lizhelun123-beep/Zynq-7020_pynq_ray_game/build/reports/camera_model_reanalysis/sampling_paths.tsv

lane | polarity | corner | data_transition | delay_type | path_count | worst_slack_ns
0 | p | Fast | rise | max | 4 | 0.036
0 | p | Fast | rise | min | 4 | 0.279
0 | p | Fast | fall | max | 4 | 0.036
0 | p | Fast | fall | min | 4 | 0.279
0 | p | Slow | rise | max | 4 | 1.016
0 | p | Slow | rise | min | 4 | -0.844
0 | p | Slow | fall | max | 4 | 1.016
0 | p | Slow | fall | min | 4 | -0.844
0 | n | Fast | rise | max | 4 | 0.034
0 | n | Fast | rise | min | 4 | 0.281
0 | n | Fast | fall | max | 4 | 0.034
0 | n | Fast | fall | min | 4 | 0.281
0 | n | Slow | rise | max | 4 | 1.014
0 | n | Slow | rise | min | 4 | -0.842
0 | n | Slow | fall | max | 4 | 1.014
0 | n | Slow | fall | min | 4 | -0.842
1 | p | Fast | rise | max | 4 | 0.023
1 | p | Fast | rise | min | 4 | 0.292
1 | p | Fast | fall | max | 4 | 0.023
1 | p | Fast | fall | min | 4 | 0.292
1 | p | Slow | rise | max | 4 | 1.002
1 | p | Slow | rise | min | 4 | -0.830
1 | p | Slow | fall | max | 4 | 1.002
1 | p | Slow | fall | min | 4 | -0.830
1 | n | Fast | rise | max | 4 | 0.021
1 | n | Fast | rise | min | 4 | 0.294
1 | n | Fast | fall | max | 4 | 0.021
1 | n | Fast | fall | min | 4 | 0.294
1 | n | Slow | rise | max | 4 | 1.000
1 | n | Slow | rise | min | 4 | -0.828
1 | n | Slow | fall | max | 4 | 1.000
1 | n | Slow | fall | min | 4 | -0.828
