lizhelun123-beep/Zynq-7020_pynq_ray_game/build/reports/camera_model_reanalysis/sampling_summary.tsv

metric | value
sampling_setup_ns | 0.021
sampling_hold_ns | -0.844
covered_queries | 32
fixed_IDELAY_and_locations | UNCHANGED
timing_status | FAIL
