lizhelun123-beep/Zynq-7020_pynq_ray_game/build/reports/final_camera_build/reports/timing_gate.tsv

delay_type | worst_slack_ns
max | 0.021
min | -0.844
