lizhelun123-beep/Zynq-7020_pynq_ray_game/build/reports/camera_model_reanalysis/inputs/pl2_reports/timing_gate.tsv

delay_type | worst_slack_ns
max | 0.303
min | -1.111
