lizhelun123-beep/Zynq-7020_pynq_ray_game/data/reference/screen_02.png

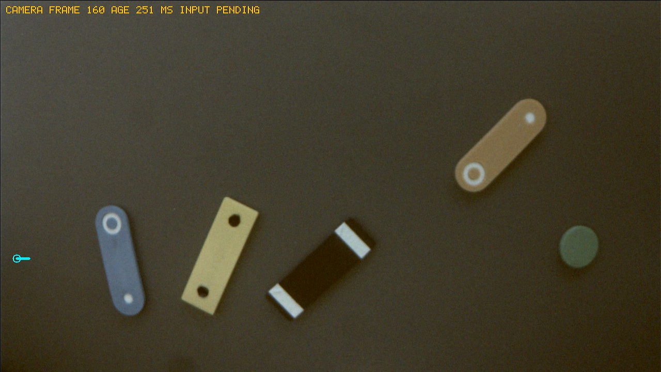
data/reference/screen_02.png
