lizhelun123-beep/Zynq-7020_pynq_ray_game/data/test_data/index.tsv

sample_id | upload_order | file | original_file | source_path | bytes | sha256 | width | height | image_mode | data_role | expected_types | observed_types | requested_placement | observed_placement | placement_review | label_basis | geometry_annotation | filename_time_semantics | reference_relationship | sensor_raw_status
43 | 1 | raw/01.png | Screenshot 2026-11-02 19-59-07.png | C:/Users/11967/Videos/Screenshot 2026-11-02 19-59-07.png | 1270483 | 2f3a45b0bfd4c9fe3474bf07124e5293e8f3855c91941d0a6402e2babf1b7486 | 1280 | 720 | RGB | ALGORITHM_TEST_INPUT | MIRROR | MIRROR | 只有Mirror，水平摆放，位于画面中部。 | 黄色主体及两端黑点，长轴近水平，单物块完整入镜。 | VISUAL_IDENTITY_AND_LAYOUT_REVIEWED | USER_REQUEST_AND_MANUAL_IMAGE_REVIEW_BEFORE_C_REPLAY | PENDING_INDEPENDENT_CENTER_AXIS_BOUNDARY_LABELS | FILENAME_ONLY_NOT_VERIFIED_EXPOSURE_TIME | NO_SYNCHRONIZED_OR_SAME_FRAME_BINDING | PNG_UPLOAD_NOT_SENSOR_RAW10
44 | 2 | raw/02.png | Screenshot 2026-11-02 19-59-19.png | C:/Users/11967/Videos/Screenshot 2026-11-02 19-59-19.png | 1301689 | 123bdf364a8dd263ad06cc3c40afd0b89b04add67df74252bbe95b522e2a0216 | 1280 | 720 | RGB | ALGORITHM_TEST_INPUT | MIRROR | MIRROR | Mirror中心基本不变，旋转为竖直。 | 黄色主体及两端黑点，长轴近竖直，单物块完整入镜。 | VISUAL_IDENTITY_AND_LAYOUT_REVIEWED | USER_REQUEST_AND_MANUAL_IMAGE_REVIEW_BEFORE_C_REPLAY | PENDING_INDEPENDENT_CENTER_AXIS_BOUNDARY_LABELS | FILENAME_ONLY_NOT_VERIFIED_EXPOSURE_TIME | NO_SYNCHRONIZED_OR_SAME_FRAME_BINDING | PNG_UPLOAD_NOT_SENSOR_RAW10
45 | 3 | raw/03.png | Screenshot 2026-11-02 19-59-26.png | C:/Users/11967/Videos/Screenshot 2026-11-02 19-59-26.png | 1323438 | 65e117a853ddf29dfbc0390baccc5861907d2da0ac96ad632eacbb465f8e55ef | 1280 | 720 | RGB | ALGORITHM_TEST_INPUT | MIRROR | MIRROR | Mirror中心基本不变，旋转为约45°。 | 黄色主体及两端黑点，长轴从左下至右上，约45°。 | VISUAL_IDENTITY_AND_LAYOUT_REVIEWED | USER_REQUEST_AND_MANUAL_IMAGE_REVIEW_BEFORE_C_REPLAY | PENDING_INDEPENDENT_CENTER_AXIS_BOUNDARY_LABELS | FILENAME_ONLY_NOT_VERIFIED_EXPOSURE_TIME | NO_SYNCHRONIZED_OR_SAME_FRAME_BINDING | PNG_UPLOAD_NOT_SENSOR_RAW10
46 | 4 | raw/07.png | Screenshot 2026-11-02 20-00-09.png | C:/Users/11967/Videos/Screenshot 2026-11-02 20-00-09.png | 1350614 | 4c739790013804a8c909c1af2ee445849e6cff5d7746e8f3e66c023ad1a7e6b9 | 1280 | 720 | RGB | ALGORITHM_TEST_INPUT | PORTAL_A | PORTAL_A | 只有Portal A，水平摆放，实心点在左、圆环在右。 | 蓝色主体，白色实心点在左、圆环在右，长轴近水平。 | VISUAL_IDENTITY_AND_LAYOUT_REVIEWED | USER_REQUEST_AND_MANUAL_IMAGE_REVIEW_BEFORE_C_REPLAY | PENDING_INDEPENDENT_CENTER_AXIS_BOUNDARY_LABELS | FILENAME_ONLY_NOT_VERIFIED_EXPOSURE_TIME | NO_SYNCHRONIZED_OR_SAME_FRAME_BINDING | PNG_UPLOAD_NOT_SENSOR_RAW10
47 | 5 | raw/05.png | Screenshot 2026-11-02 19-59-50.png | C:/Users/11967/Videos/Screenshot 2026-11-02 19-59-50.png | 1344861 | 70a1481f10ec8632ddb638e63eaa113ec23644ea6bdb5571796d05816061ed20 | 1280 | 720 | RGB | ALGORITHM_TEST_INPUT | PORTAL_A | PORTAL_A | Portal A竖直摆放，实心点在下、圆环在上。 | 蓝色主体，白色实心点在下、圆环在上，长轴近竖直。 | VISUAL_IDENTITY_AND_LAYOUT_REVIEWED | USER_REQUEST_AND_MANUAL_IMAGE_REVIEW_BEFORE_C_REPLAY | PENDING_INDEPENDENT_CENTER_AXIS_BOUNDARY_LABELS | FILENAME_ONLY_NOT_VERIFIED_EXPOSURE_TIME | NO_SYNCHRONIZED_OR_SAME_FRAME_BINDING | PNG_UPLOAD_NOT_SENSOR_RAW10
48 | 6 | raw/06.png | Screenshot 2026-11-02 20-00-00.png | C:/Users/11967/Videos/Screenshot 2026-11-02 20-00-00.png | 1345926 | 95be681b8a0554215d866c6fdedefc4556b70f96fe7e083aceb2ffe74dc683e9 | 1280 | 720 | RGB | ALGORITHM_TEST_INPUT | PORTAL_A | PORTAL_A | Portal A约45°摆放，实心点在左下、圆环在右上。 | 蓝色主体，白色实心点在左下、圆环在右上，长轴约45°。 | VISUAL_IDENTITY_AND_LAYOUT_REVIEWED | USER_REQUEST_AND_MANUAL_IMAGE_REVIEW_BEFORE_C_REPLAY | PENDING_INDEPENDENT_CENTER_AXIS_BOUNDARY_LABELS | FILENAME_ONLY_NOT_VERIFIED_EXPOSURE_TIME | NO_SYNCHRONIZED_OR_SAME_FRAME_BINDING | PNG_UPLOAD_NOT_SENSOR_RAW10
49 | 7 | raw/04.png | Screenshot 2026-11-02 19-59-38.png | C:/Users/11967/Videos/Screenshot 2026-11-02 19-59-38.png | 1313438 | ba6139d1a51e422aa84b228ab6b405609d179cca18bbc5f0a7e528cc7624eb6c | 1280 | 720 | RGB | ALGORITHM_TEST_INPUT | PORTAL_A | PORTAL_A | Portal A水平反向摆放，实心点在右、圆环在左。 | 蓝色主体，白色实心点在右、圆环在左，长轴近水平。 | VISUAL_IDENTITY_AND_LAYOUT_REVIEWED | USER_REQUEST_AND_MANUAL_IMAGE_REVIEW_BEFORE_C_REPLAY | PENDING_INDEPENDENT_CENTER_AXIS_BOUNDARY_LABELS | FILENAME_ONLY_NOT_VERIFIED_EXPOSURE_TIME | NO_SYNCHRONIZED_OR_SAME_FRAME_BINDING | PNG_UPLOAD_NOT_SENSOR_RAW10
50 | 8 | raw/08.png | Screenshot 2026-11-02 20-00-39.png | C:/Users/11967/Videos/Screenshot 2026-11-02 20-00-39.png | 1370984 | 831b0ded6e29ecee51226f95462f2510518f40d29e7abd3ff05f95d32c1e73b6 | 1280 | 720 | RGB | ALGORITHM_TEST_INPUT | PORTAL_B | PORTAL_B | 只有Portal B，水平摆放，实心点在左、圆环在右。 | 橙色主体，白色实心点在左、圆环在右，长轴近水平。 | VISUAL_IDENTITY_AND_LAYOUT_REVIEWED | USER_REQUEST_AND_MANUAL_IMAGE_REVIEW_BEFORE_C_REPLAY | PENDING_INDEPENDENT_CENTER_AXIS_BOUNDARY_LABELS | FILENAME_ONLY_NOT_VERIFIED_EXPOSURE_TIME | NO_SYNCHRONIZED_OR_SAME_FRAME_BINDING | PNG_UPLOAD_NOT_SENSOR_RAW10
51 | 9 | raw/09.png | Screenshot 2026-11-02 20-00-53.png | C:/Users/11967/Videos/Screenshot 2026-11-02 20-00-53.png | 1376443 | 513a161e1db5ed2d8f65e204740cf6f02557e9e55281cee433263ee47509b2ad | 1280 | 720 | RGB | ALGORITHM_TEST_INPUT | PORTAL_B | PORTAL_B | Portal B竖直摆放，实心点在下、圆环在上。 | 橙色主体，白色实心点在下、圆环在上，长轴近竖直。 | VISUAL_IDENTITY_AND_LAYOUT_REVIEWED | USER_REQUEST_AND_MANUAL_IMAGE_REVIEW_BEFORE_C_REPLAY | PENDING_INDEPENDENT_CENTER_AXIS_BOUNDARY_LABELS | FILENAME_ONLY_NOT_VERIFIED_EXPOSURE_TIME | NO_SYNCHRONIZED_OR_SAME_FRAME_BINDING | PNG_UPLOAD_NOT_SENSOR_RAW10
52 | 10 | raw/10.png | Screenshot 2026-11-02 20-00-59.png | C:/Users/11967/Videos/Screenshot 2026-11-02 20-00-59.png | 1377696 | 8d167ce49a91a2117f9b7bee8b43513886d5db915b36d2b0f6699d26568319ce | 1280 | 720 | RGB | ALGORITHM_TEST_INPUT | PORTAL_B | PORTAL_B | Portal B约45°摆放，实心点在左下、圆环在右上。 | 橙色主体，白色实心点在左下、圆环在右上，长轴约45°。 | VISUAL_IDENTITY_AND_LAYOUT_REVIEWED | USER_REQUEST_AND_MANUAL_IMAGE_REVIEW_BEFORE_C_REPLAY | PENDING_INDEPENDENT_CENTER_AXIS_BOUNDARY_LABELS | FILENAME_ONLY_NOT_VERIFIED_EXPOSURE_TIME | NO_SYNCHRONIZED_OR_SAME_FRAME_BINDING | PNG_UPLOAD_NOT_SENSOR_RAW10
53 | 11 | raw/11.png | Screenshot 2026-11-02 20-02-07.png | C:/Users/11967/Videos/Screenshot 2026-11-02 20-02-07.png | 1395611 | 94b515042fd1ad5d4e42d4cc2a1c4e7682ccf41fbc4f03802dda197e801b23cd | 1280 | 720 | RGB | ALGORITHM_TEST_INPUT | PORTAL_B | PORTAL_B | Portal B水平反向摆放，实心点在右、圆环在左。 | 橙色主体，白色实心点在右、圆环在左，长轴近水平。 | VISUAL_IDENTITY_AND_LAYOUT_REVIEWED | USER_REQUEST_AND_MANUAL_IMAGE_REVIEW_BEFORE_C_REPLAY | PENDING_INDEPENDENT_CENTER_AXIS_BOUNDARY_LABELS | FILENAME_ONLY_NOT_VERIFIED_EXPOSURE_TIME | NO_SYNCHRONIZED_OR_SAME_FRAME_BINDING | PNG_UPLOAD_NOT_SENSOR_RAW10
54 | 12 | raw/12.png | Screenshot 2026-11-02 20-02-17.png | C:/Users/11967/Videos/Screenshot 2026-11-02 20-02-17.png | 1393155 | 370e5a95cc30109d4b3005c137089873bfe207f99f4f6320b11b1553fa2c3e4e | 1280 | 720 | RGB | ALGORITHM_TEST_INPUT | WALL | WALL | 只有WALL，水平摆放，两端白色标记完整可见。 | 黑色条状主体，左右两端白条完整，长轴近水平。 | VISUAL_IDENTITY_AND_LAYOUT_REVIEWED | USER_REQUEST_AND_MANUAL_IMAGE_REVIEW_BEFORE_C_REPLAY | PENDING_INDEPENDENT_CENTER_AXIS_BOUNDARY_LABELS | FILENAME_ONLY_NOT_VERIFIED_EXPOSURE_TIME | NO_SYNCHRONIZED_OR_SAME_FRAME_BINDING | PNG_UPLOAD_NOT_SENSOR_RAW10
55 | 13 | raw/13.png | Screenshot 2026-11-02 20-02-27.png | C:/Users/11967/Videos/Screenshot 2026-11-02 20-02-27.png | 1397522 | 25cd7a6c5181fd2b277d5bf987df8fd6235429834e63f8f7e1e0a70fc6c1058d | 1280 | 720 | RGB | ALGORITHM_TEST_INPUT | WALL | WALL | WALL中心基本不变，旋转为竖直。 | 黑色条状主体，上下两端白条完整，长轴近竖直。 | VISUAL_IDENTITY_AND_LAYOUT_REVIEWED | USER_REQUEST_AND_MANUAL_IMAGE_REVIEW_BEFORE_C_REPLAY | PENDING_INDEPENDENT_CENTER_AXIS_BOUNDARY_LABELS | FILENAME_ONLY_NOT_VERIFIED_EXPOSURE_TIME | NO_SYNCHRONIZED_OR_SAME_FRAME_BINDING | PNG_UPLOAD_NOT_SENSOR_RAW10
56 | 14 | raw/14.png | Screenshot 2026-11-02 20-02-32.png | C:/Users/11967/Videos/Screenshot 2026-11-02 20-02-32.png | 1399271 | 9eee3dae4d5c119a5525255c1d3c501641b919a8e30fe9e2309180a5eaee42ba | 1280 | 720 | RGB | ALGORITHM_TEST_INPUT | WALL | WALL | WALL中心基本不变，旋转为约45°。 | 黑色条状主体，左下及右上两端白条完整，长轴约45°。 | VISUAL_IDENTITY_AND_LAYOUT_REVIEWED | USER_REQUEST_AND_MANUAL_IMAGE_REVIEW_BEFORE_C_REPLAY | PENDING_INDEPENDENT_CENTER_AXIS_BOUNDARY_LABELS | FILENAME_ONLY_NOT_VERIFIED_EXPOSURE_TIME | NO_SYNCHRONIZED_OR_SAME_FRAME_BINDING | PNG_UPLOAD_NOT_SENSOR_RAW10
57 | 15 | raw/15.png | Screenshot 2026-11-02 20-02-41.png | C:/Users/11967/Videos/Screenshot 2026-11-02 20-02-41.png | 1400688 | 037862dcbe06970b7ca0626e99148379db882f337940cf209bc1e69d8fe13807 | 1280 | 720 | RGB | ALGORITHM_TEST_INPUT | TARGET | TARGET | 只有Target，放在画面中央。 | 绿色圆形Target，位于画面中央附近，完整入镜。 | VISUAL_IDENTITY_AND_LAYOUT_REVIEWED | USER_REQUEST_AND_MANUAL_IMAGE_REVIEW_BEFORE_C_REPLAY | PENDING_INDEPENDENT_CENTER_AXIS_BOUNDARY_LABELS | FILENAME_ONLY_NOT_VERIFIED_EXPOSURE_TIME | NO_SYNCHRONIZED_OR_SAME_FRAME_BINDING | PNG_UPLOAD_NOT_SENSOR_RAW10
58 | 16 | raw/16.png | Screenshot 2026-11-02 20-02-48.png | C:/Users/11967/Videos/Screenshot 2026-11-02 20-02-48.png | 1397362 | 28fc8bf925732552c63430503873e98fc251a9554b210427d61accdb66e75b4c | 1280 | 720 | RGB | ALGORITHM_TEST_INPUT | TARGET | TARGET | Target放在左上区域，完整入镜并留边。 | 绿色圆形Target，位于左上区域，完整入镜并留边。 | VISUAL_IDENTITY_AND_LAYOUT_REVIEWED | USER_REQUEST_AND_MANUAL_IMAGE_REVIEW_BEFORE_C_REPLAY | PENDING_INDEPENDENT_CENTER_AXIS_BOUNDARY_LABELS | FILENAME_ONLY_NOT_VERIFIED_EXPOSURE_TIME | NO_SYNCHRONIZED_OR_SAME_FRAME_BINDING | PNG_UPLOAD_NOT_SENSOR_RAW10
59 | 17 | raw/17.png | Screenshot 2026-11-02 20-02-54.png | C:/Users/11967/Videos/Screenshot 2026-11-02 20-02-54.png | 1398810 | 47368bc88837ad782b83bc1ae56c29bf392019dc20263651b3bedce66dbb8a83 | 1280 | 720 | RGB | ALGORITHM_TEST_INPUT | TARGET | TARGET | Target放在右上区域，完整入镜并留边。 | 绿色圆形Target，位于右上区域，完整入镜并留边。 | VISUAL_IDENTITY_AND_LAYOUT_REVIEWED | USER_REQUEST_AND_MANUAL_IMAGE_REVIEW_BEFORE_C_REPLAY | PENDING_INDEPENDENT_CENTER_AXIS_BOUNDARY_LABELS | FILENAME_ONLY_NOT_VERIFIED_EXPOSURE_TIME | NO_SYNCHRONIZED_OR_SAME_FRAME_BINDING | PNG_UPLOAD_NOT_SENSOR_RAW10
60 | 18 | raw/18.png | Screenshot 2026-11-02 20-03-00.png | C:/Users/11967/Videos/Screenshot 2026-11-02 20-03-00.png | 1403587 | 4af9ef71a9bdafd9e7ac925378949e2a0de953861b67ed7c9b332c7a7f2a1dd5 | 1280 | 720 | RGB | ALGORITHM_TEST_INPUT | TARGET | TARGET | Target放在左下区域，完整入镜并留边。 | 绿色圆形Target，位于左下区域，完整入镜并留边。 | VISUAL_IDENTITY_AND_LAYOUT_REVIEWED | USER_REQUEST_AND_MANUAL_IMAGE_REVIEW_BEFORE_C_REPLAY | PENDING_INDEPENDENT_CENTER_AXIS_BOUNDARY_LABELS | FILENAME_ONLY_NOT_VERIFIED_EXPOSURE_TIME | NO_SYNCHRONIZED_OR_SAME_FRAME_BINDING | PNG_UPLOAD_NOT_SENSOR_RAW10
61 | 19 | raw/19.png | Screenshot 2026-11-02 20-03-06.png | C:/Users/11967/Videos/Screenshot 2026-11-02 20-03-06.png | 1391458 | 49904cf789f9c1cfd9a5990e7b267402fb1ea0ca718a77e8af1104f6284bb609 | 1280 | 720 | RGB | ALGORITHM_TEST_INPUT | TARGET | TARGET | Target放在右下区域，完整入镜并留边。 | 绿色圆形Target，位于右下区域，完整入镜并留边。 | VISUAL_IDENTITY_AND_LAYOUT_REVIEWED | USER_REQUEST_AND_MANUAL_IMAGE_REVIEW_BEFORE_C_REPLAY | PENDING_INDEPENDENT_CENTER_AXIS_BOUNDARY_LABELS | FILENAME_ONLY_NOT_VERIFIED_EXPOSURE_TIME | NO_SYNCHRONIZED_OR_SAME_FRAME_BINDING | PNG_UPLOAD_NOT_SENSOR_RAW10
62 | 20 | raw/20.png | Screenshot 2026-11-02 20-03-21.png | C:/Users/11967/Videos/Screenshot 2026-11-02 20-03-21.png | 1390234 | 16fa88c05733cfe5efb2e3e4152d6e2c81df6977cd7546abd3ade172dc347ccd | 1280 | 720 | RGB | ALGORITHM_TEST_INPUT | MIRROR;PORTAL_A;PORTAL_B;WALL;TARGET | MIRROR;PORTAL_A;PORTAL_B;WALL;TARGET | 五个正式物块全部放入，采用另一套位置和方向。 | 五物块均完整可见、无明显重叠；保留此图的摆放信息，不再与已排除图片比较。 | VISUAL_IDENTITY_AND_LAYOUT_REVIEWED | USER_REQUEST_AND_MANUAL_IMAGE_REVIEW_BEFORE_C_REPLAY | PENDING_INDEPENDENT_CENTER_AXIS_BOUNDARY_LABELS | FILENAME_ONLY_NOT_VERIFIED_EXPOSURE_TIME | NO_SYNCHRONIZED_OR_SAME_FRAME_BINDING | PNG_UPLOAD_NOT_SENSOR_RAW10
42 | 22 | raw/42.png | Screenshot 2026-11-02 19-58-47.png | C:/Users/11967/Videos/Screenshot 2026-11-02 19-58-47.png | 1256457 | b9178000612b9bf7059e6fe340c3945c5a4c7cea89f5b0608f5020081a241d51 | 1280 | 720 | RGB | ALGORITHM_TEST_INPUT |  |  | 移走全部物块和手，拍空场。 | 空场，画面内未见五类正式物块或手。 | VISUAL_IDENTITY_AND_LAYOUT_REVIEWED | USER_CONFIRMED_SAMPLE_ID_AND_MANUAL_IMAGE_REVIEW_BEFORE_C_REPLAY | NOT_APPLICABLE_EMPTY_SCENE | FILENAME_ONLY_NOT_VERIFIED_EXPOSURE_TIME | NO_SYNCHRONIZED_OR_SAME_FRAME_BINDING | PNG_UPLOAD_NOT_SENSOR_RAW10
