lizhelun123-beep/Zynq-7020_pynq_ray_game/build/reports/sampling_window_build/sampling_analysis/declared_25_75_paths.tsv

lane | polarity | corner | data_transition | delay_type | path_count | worst_slack_ns
0 | p | Fast | rise | max | 4 | 0.150
0 | p | Fast | rise | min | 4 | 0.942
0 | p | Fast | fall | max | 4 | 0.150
0 | p | Fast | fall | min | 4 | 0.942
0 | p | Slow | rise | max | 4 | 0.711
0 | p | Slow | rise | min | 4 | 0.201
0 | p | Slow | fall | max | 4 | 0.711
0 | p | Slow | fall | min | 4 | 0.201
0 | n | Fast | rise | max | 4 | 0.148
0 | n | Fast | rise | min | 4 | 0.944
0 | n | Fast | fall | max | 4 | 0.148
0 | n | Fast | fall | min | 4 | 0.944
0 | n | Slow | rise | max | 4 | 0.709
0 | n | Slow | rise | min | 4 | 0.203
0 | n | Slow | fall | max | 4 | 0.709
0 | n | Slow | fall | min | 4 | 0.203
1 | p | Fast | rise | max | 4 | 0.137
1 | p | Fast | rise | min | 4 | 0.955
1 | p | Fast | fall | max | 4 | 0.137
1 | p | Fast | fall | min | 4 | 0.955
1 | p | Slow | rise | max | 4 | 0.697
1 | p | Slow | rise | min | 4 | 0.215
1 | p | Slow | fall | max | 4 | 0.697
1 | p | Slow | fall | min | 4 | 0.215
1 | n | Fast | rise | max | 4 | 0.135
1 | n | Fast | rise | min | 4 | 0.957
1 | n | Fast | fall | max | 4 | 0.135
1 | n | Fast | fall | min | 4 | 0.957
1 | n | Slow | rise | max | 4 | 0.695
1 | n | Slow | rise | min | 4 | 0.217
1 | n | Slow | fall | max | 4 | 0.695
1 | n | Slow | fall | min | 4 | 0.217
