lizhelun123-beep/Zynq-7020_pynq_ray_game/build/reports/sampling_window_build/sampling_analysis/historical_15_85_paths.tsv

lane | polarity | corner | data_transition | delay_type | path_count | worst_slack_ns
0 | p | Fast | rise | max | 4 | -0.207
0 | p | Fast | rise | min | 4 | 0.585
0 | p | Fast | fall | max | 4 | -0.207
0 | p | Fast | fall | min | 4 | 0.585
0 | p | Slow | rise | max | 4 | 0.354
0 | p | Slow | rise | min | 4 | -0.156
0 | p | Slow | fall | max | 4 | 0.354
0 | p | Slow | fall | min | 4 | -0.156
0 | n | Fast | rise | max | 4 | -0.209
0 | n | Fast | rise | min | 4 | 0.587
0 | n | Fast | fall | max | 4 | -0.209
0 | n | Fast | fall | min | 4 | 0.587
0 | n | Slow | rise | max | 4 | 0.352
0 | n | Slow | rise | min | 4 | -0.154
0 | n | Slow | fall | max | 4 | 0.352
0 | n | Slow | fall | min | 4 | -0.154
1 | p | Fast | rise | max | 4 | -0.220
1 | p | Fast | rise | min | 4 | 0.598
1 | p | Fast | fall | max | 4 | -0.220
1 | p | Fast | fall | min | 4 | 0.598
1 | p | Slow | rise | max | 4 | 0.340
1 | p | Slow | rise | min | 4 | -0.142
1 | p | Slow | fall | max | 4 | 0.340
1 | p | Slow | fall | min | 4 | -0.142
1 | n | Fast | rise | max | 4 | -0.222
1 | n | Fast | rise | min | 4 | 0.600
1 | n | Fast | fall | max | 4 | -0.222
1 | n | Fast | fall | min | 4 | 0.600
1 | n | Slow | rise | max | 4 | 0.338
1 | n | Slow | rise | min | 4 | -0.140
1 | n | Slow | fall | max | 4 | 0.338
1 | n | Slow | fall | min | 4 | -0.140
