lizhelun123-beep/Zynq-7020_pynq_ray_game/build/reports/sampling_window_build/sampling_analysis/sampling_summary.tsv

model | min_input_ns | max_input_ns | queries | paths | setup_ns | hold_ns | qualification
declared_25_75 | 0.892 | 2.679 | 32 | 128 | 0.135 | 0.201 | PASS_UNDER_DECLARED_MODEL
historical_15_85 | 0.535 | 3.036 | 32 | 128 | -0.222 | -0.156 | FAIL
