lizhelun123-beep/Zynq-7020_pynq_ray_game/build/reports/final_camera_build/reports/timing_result.tsv

status | detail
FAIL | min: slack=-0.844; Timing summary does not confirm all user timing constraints
