lizhelun123-beep/Zynq-7020_pynq_ray_game/build/reports/sampling_window_build/reports/timing_result.tsv

status | detail
PASS
