lizhelun123-beep/Zynq-7020_pynq_ray_game/data/reference_results/hdmi/index.tsv

sample_id | file | original_file | bytes | sha256 | width | height | displayed_frame | displayed_age_ms | display_mode | input_status | runtime_version | evidence_type | visual_note | data_role | algorithm_test_input | capture_relationship | reference_use
hdmi_001 | hdmi_001.png | Screenshot 2026-11-02 18-38-25.png | 1386012 | 5b880dfa2e9c79b9326dc334579db036ef34efebfa548cccd09f56058130bfe3 | 1280 | 720 | 363 | 280 | CAMERA | OK | UNBOUND | user-provided HDMI screenshot with existing overlay | orange portal, mirror, target; short ray ending near portal | REFERENCE_RESULT | NO | NOT_SYNCHRONOUS_USER_CONFIRMED | layout and visible output illustration only
hdmi_002 | hdmi_002.png | Screenshot 2026-11-02 18-38-32.png | 1386903 | 41984f7cbbfeb187953bff6a232b742a2f3f0f476d5afef540b29fd43196628e | 1280 | 720 | 381 | 278 | CAMERA | OK | UNBOUND | user-provided HDMI screenshot with existing overlay | same visible arrangement as preceding image | REFERENCE_RESULT | NO | NOT_SYNCHRONOUS_USER_CONFIRMED | layout and visible output illustration only
hdmi_003 | hdmi_003.png | Screenshot 2026-11-02 18-41-24.png | 1397052 | 61dcbca690ed41cd0d2fb9c48621f09bb4d43c69c23f4bf3ce61ceca53110c7c | 1280 | 720 | 820 | 2145 | STALE | PENDING | UNBOUND | user-provided HDMI screenshot with existing overlay | five visible object types; portal ray segments | REFERENCE_RESULT | NO | NOT_SYNCHRONOUS_USER_CONFIRMED | layout and visible output illustration only
hdmi_004 | hdmi_004.png | Screenshot 2026-11-02 18-43-38.png | 1405172 | 8f737a3609249bccfffefdca320d72791a3009df4faeda5166ec141c812314d7 | 1280 | 720 | 1134 | 2244 | STALE | PENDING | UNBOUND | user-provided HDMI screenshot with existing overlay | five visible object types; mirror reflection | REFERENCE_RESULT | NO | NOT_SYNCHRONOUS_USER_CONFIRMED | layout and visible output illustration only
hdmi_005 | hdmi_005.png | Screenshot 2026-11-02 18-45-14.png | 1409329 | 90884076a8d7a57e5248b9cb5659fa8e731771b9191c1392b8befafd5651dc40 | 1280 | 720 | 1380 | 617 | STALE | PENDING | UNBOUND | user-provided HDMI screenshot with existing overlay | mirror and target; reflection near mirror middle | REFERENCE_RESULT | NO | NOT_SYNCHRONOUS_USER_CONFIRMED | layout and visible output illustration only
hdmi_006 | hdmi_006.png | Screenshot 2026-11-02 18-45-53.png | 1409463 | ab71a9766c86aa8c9683ecaf4aac73207e2e699038058a88701817a4500fe056 | 1280 | 720 | 1489 | 631 | STALE | PENDING | UNBOUND | user-provided HDMI screenshot with existing overlay | mirror and target; reflection nearer one mirror end | REFERENCE_RESULT | NO | NOT_SYNCHRONOUS_USER_CONFIRMED | layout and visible output illustration only
hdmi_007 | hdmi_007.png | Screenshot 2026-11-02 18-48-19.png | 1404832 | d4756cdafccd4346ec1dc99fbe9b5bc9661ef518ae037bb774e0272071a4484d | 1280 | 720 | 1875 | 305 | CAMERA | OK | UNBOUND | user-provided HDMI screenshot with existing overlay | two portals and target; orange portal roughly horizontal | REFERENCE_RESULT | NO | NOT_SYNCHRONOUS_USER_CONFIRMED | layout and visible output illustration only
hdmi_008 | hdmi_008.png | Screenshot 2026-11-02 18-48-47.png | 1403214 | 75b6f14f523c53ab6315edb4f4d50af00851665793cf906bc3c4cea4c3f469af | 1280 | 720 | 1944 | 1374 | STALE | PENDING | UNBOUND | user-provided HDMI screenshot with existing overlay | two portals and target; portal endpoint orientation changed | REFERENCE_RESULT | NO | NOT_SYNCHRONOUS_USER_CONFIRMED | layout and visible output illustration only
hdmi_009 | hdmi_009.png | Screenshot 2026-11-02 18-49-31.png | 1406291 | 0bb3f1314a4a776122567ef270aee195c966ae702657381ff29f3b9831544f7e | 1280 | 720 | 2066 | 640 | STALE | PENDING | UNBOUND | user-provided HDMI screenshot with existing overlay | two portals and target; orange portal slightly tilted | REFERENCE_RESULT | NO | NOT_SYNCHRONOUS_USER_CONFIRMED | layout and visible output illustration only
hdmi_010 | hdmi_010.png | Screenshot 2026-11-02 18-49-57.png | 1401296 | dad8c7df259dca3534986f7b591c9a48b94901a795ac0bc290c6c8f44a3e8eb5 | 1280 | 720 | 2136 | 1018 | STALE | PENDING | UNBOUND | user-provided HDMI screenshot with existing overlay | two portals and target; orange portal roughly vertical | REFERENCE_RESULT | NO | NOT_SYNCHRONOUS_USER_CONFIRMED | layout and visible output illustration only
hdmi_011 | hdmi_011.png | Screenshot 2026-11-02 18-50-42.png | 1403848 | fa3e7d285351535194ef2a822125967efee440ad7f9e26c1d7984ed33e080c3f | 1280 | 720 | 2259 | 652 | STALE | PENDING | UNBOUND | user-provided HDMI screenshot with existing overlay | same visible arrangement as preceding image | REFERENCE_RESULT | NO | NOT_SYNCHRONOUS_USER_CONFIRMED | layout and visible output illustration only
hdmi_012 | hdmi_012.png | Screenshot 2026-11-02 18-52-21.png | 1397698 | e45a2db6336df5d52de97e75075b638a9243c3a64b1967798c4a1e3c15161d68 | 1280 | 720 | 2515 | 1906 | STALE | PENDING | UNBOUND | user-provided HDMI screenshot with existing overlay | wall, mirror and target; ray ending near wall | REFERENCE_RESULT | NO | NOT_SYNCHRONOUS_USER_CONFIRMED | layout and visible output illustration only
hdmi_013 | hdmi_013.png | Screenshot 2026-11-02 18-52-48.png | 1404711 | de6dad9e22c3784c453acd44ff76f6ae2785aff3e2a7801217d29f68bfae8d4e | 1280 | 720 | 2580 | 2305 | STALE | PENDING | UNBOUND | user-provided HDMI screenshot with existing overlay | wall, mirror and target; reflected segment | REFERENCE_RESULT | NO | NOT_SYNCHRONOUS_USER_CONFIRMED | layout and visible output illustration only
hdmi_014 | hdmi_014.png | Screenshot 2026-11-02 18-53-27.png | 1402603 | ab10778645e155257ef8009d4c8e50a8c6de2b51d640b7abe874170b1a573a19 | 1280 | 720 | 2682 | 1103 | STALE | PENDING | UNBOUND | user-provided HDMI screenshot with existing overlay | wall, mirror and target; ray reaches target boundary region | REFERENCE_RESULT | NO | NOT_SYNCHRONOUS_USER_CONFIRMED | layout and visible output illustration only
hdmi_015 | hdmi_015.png | Screenshot 2026-11-02 18-54-05.png | 1404227 | 104cefe37f90c79c71b02440f658f299fafea70a5bc29e8757f22b73af320e7e | 1280 | 720 | 2780 | 725 | STALE | PENDING | UNBOUND | user-provided HDMI screenshot with existing overlay | wall, mirror and target; reflected ray passes beside target | REFERENCE_RESULT | NO | NOT_SYNCHRONOUS_USER_CONFIRMED | layout and visible output illustration only
hdmi_016 | hdmi_016.png | Screenshot 2026-11-02 18-58-25.png | 1410414 | ef4bc1907b7f03f698a6255b4fba77d0a10d0569ba948187cea155045babd68f | 1280 | 720 | 3391 | 1914 | STALE | PENDING | UNBOUND | user-provided HDMI screenshot with existing overlay | five visible object types; portal transfer and mirror reflection | REFERENCE_RESULT | NO | NOT_SYNCHRONOUS_USER_CONFIRMED | layout and visible output illustration only
