lizhelun123-beep/Zynq-7020_pynq_ray_game/data/reference_results/hdmi/hdmi_006.png

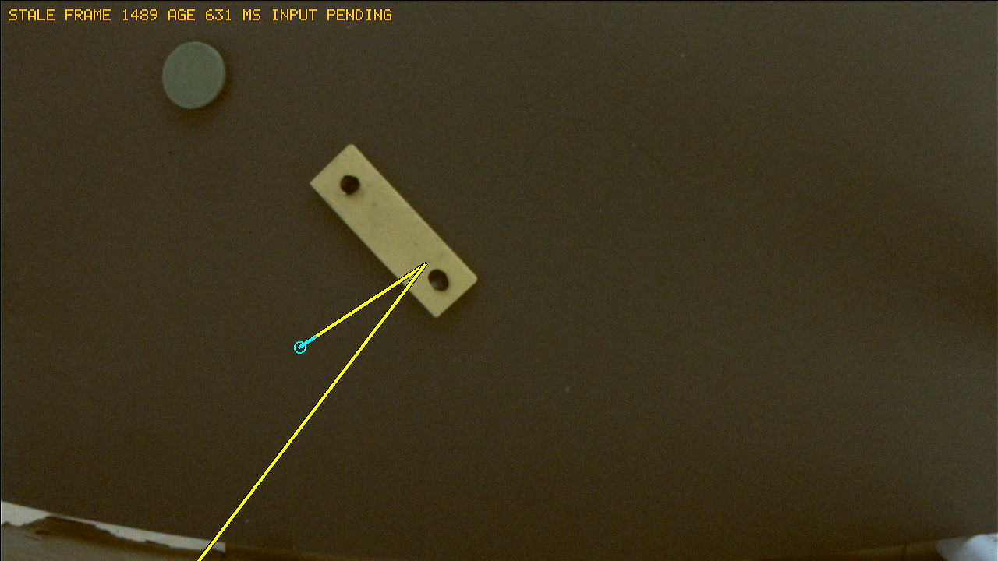
data/reference_results/hdmi/hdmi_006.png
