lizhelun123-beep/Zynq-7020_pynq_ray_game/data/reference_results/hdmi/hdmi_012.png

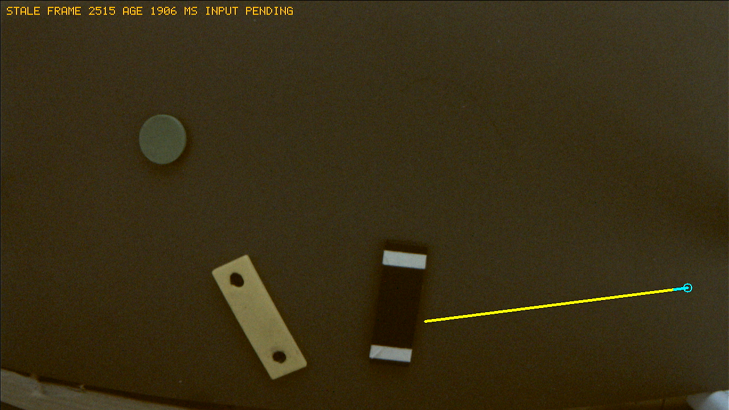
data/reference_results/hdmi/hdmi_012.png
