lizhelun123-beep/Zynq-7020_pynq_ray_game/data/reference_results/web/web_009.png

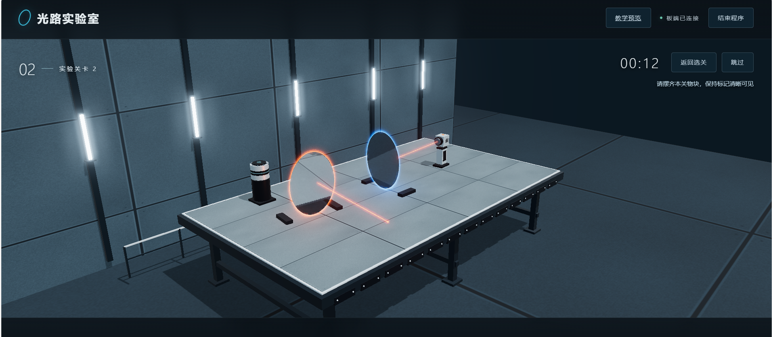
data/reference_results/web/web_009.png
