lizhelun123-beep/Zynq-7020_pynq_ray_game/data/results/replay_2/screen_01_comparison.png

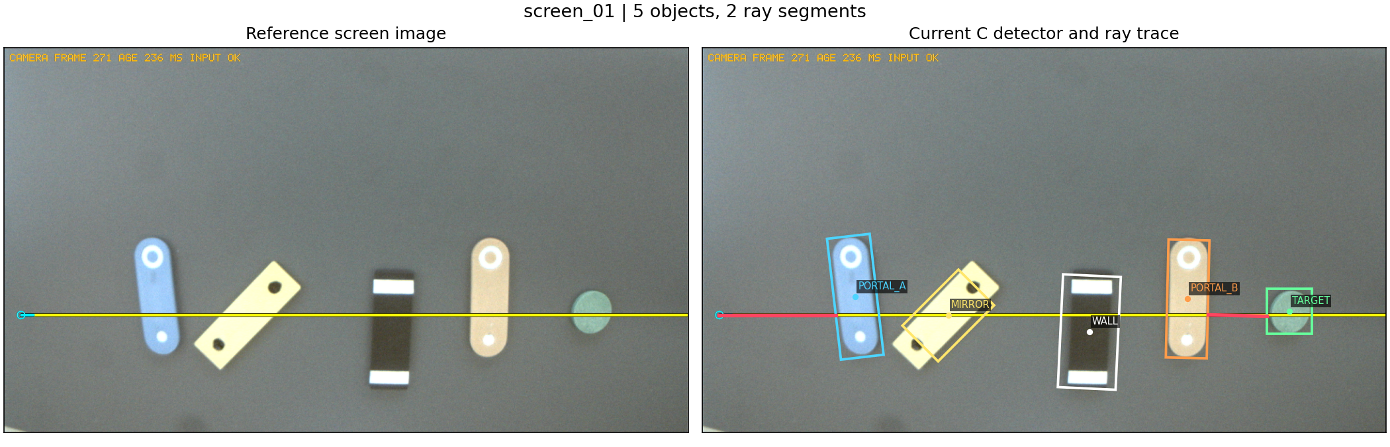
data/results/replay_2/screen_01_comparison.png
