lizhelun123-beep/Zynq-7020_pynq_ray_game/data/test_data/derived/replay_1/case_42_comparison.png

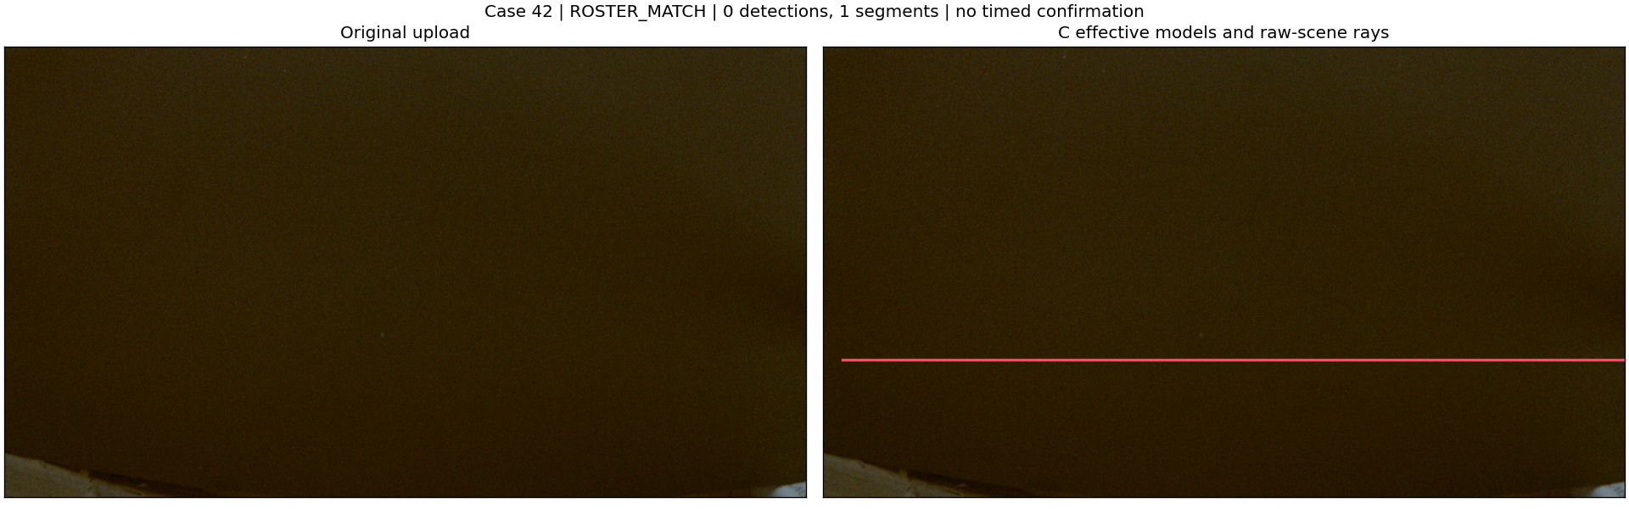
data/test_data/derived/replay_1/case_42_comparison.png
