lizhelun123-beep/Zynq-7020_pynq_ray_game/data/test_data/raw/16.png

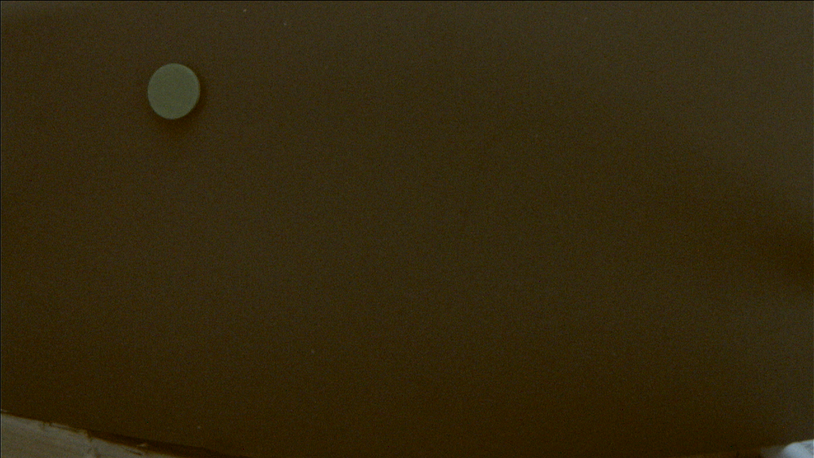
data/test_data/raw/16.png
