lizhelun123-beep/Zynq-7020_pynq_ray_game/data/test_data/raw/42.png

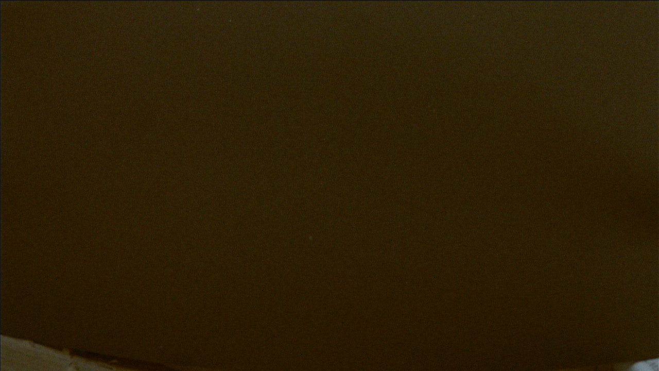
data/test_data/raw/42.png
