lizhelun123-beep/Zynq-7020_pynq_ray_game/src/project/color_test/repo/ip/mipi_csi_2_rx/docs/mipi_csi_2_rx.pdf

1300 Henley Court
Pullman, WA 99163
509.334.6306
www.digilentinc.com

## MIPI CSI-2 Receiver 1.0 IP Core User Guide

Revised December 14, 2017; Author Elod Gyorgy

DOC#: 516-000 | Copyright Digilent, Inc. All rights reserved.
Other product and company names mentioned may be trademarks of their respective owners. | Page 1 of 2

## 1 Introduction

This user guide describes the Digilent MIPI CSI-2 Receiver Intellectual Property. This IP is compatible with CSI-2 1.0 specifications and supports decoding selected pixel formats and packing data into an AXI-Stream. It pairs up with a MIPI D-PHY Receiver IP over the standard PHY Protocol Interface (PPI) to source a video subsystem.

## 2 Features

- Single or dual lane support
- RAW10 support
- Four pixels per beat AXI-Stream output for high bandwidth applications
- Xilinx interfaces used: AXI4-Lite, AXI-Stream, rx_mipi_ppi_if_rtl:1.0

## 3 Performance

The IP has been tested in dual-lane configuration with an 84 MHz PPI high-speed byte clock (RxByteClkHS) and 150 MHz AXI-Stream clock (video_aclk).

IP quick facts

Supported device
families | Zynq®-7000, 7 series
Supported user interfaces | Xilinx®: AXI4-Lite,
| AXI-Stream,
| rx_mipi_ppi

Provided with core

Design files | VHDL
Simulation model | VHDL Behavioral
Constraints file | XDC
Software driver | standalone

Tested design flows

Design entry | Vivado™ Design
| Suite 2016.4
Synthesis | Vivado Synthesis
| 2016.4

## 4 Overview

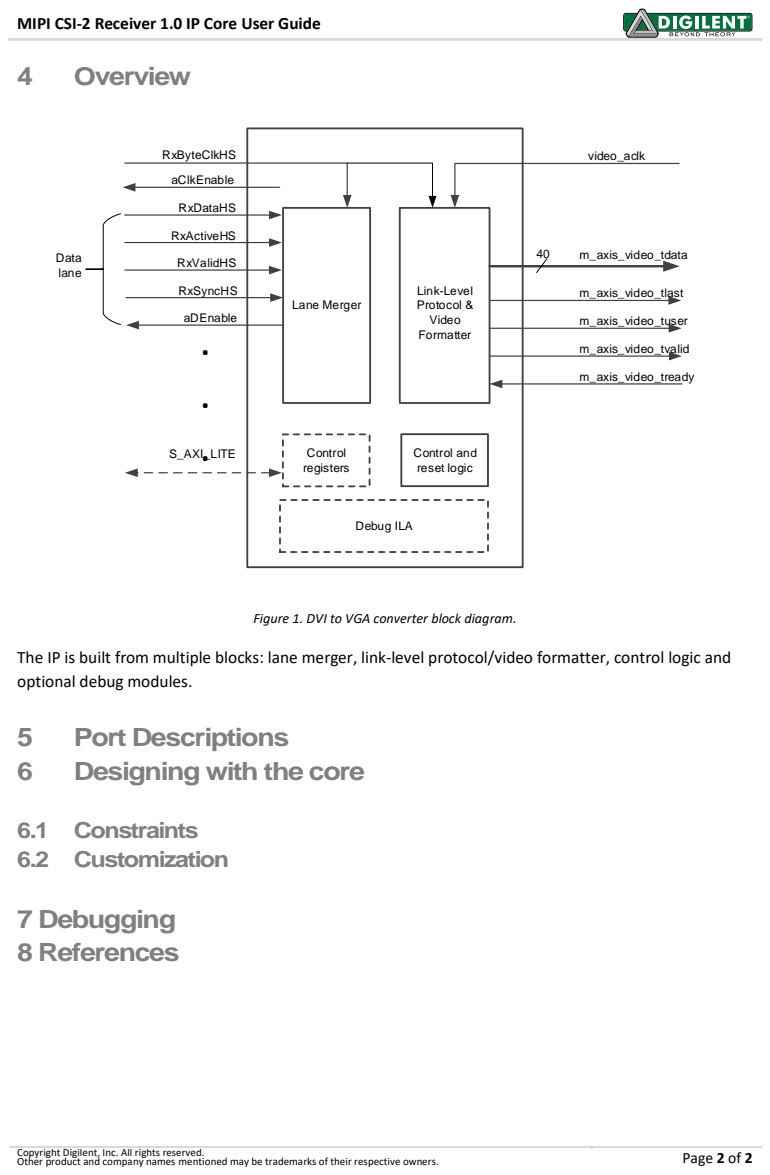
[picture p105: page 2]
Other product and company names mentioned may be trademarks of their respective owners.; Page 2 of 2; Control and reset logic; Lane Merger; Control registers; video_aclk; Debug ILA; RxByteClkHS; RxDataHS; RxActiveHS; RxValidHS; RxSyncHS; aDEnable; aClkEnable; Data lane; Link-Level Protocol & Video Formatter; m_axis_video_tdata; m_axis_video_tlast; m_axis_video_tuser; m_axis_video_tvalid; m_axis_video_tready; S_AXI_LITE; 6.1 Constraints 6.2 Customization; 7 Debugging 8 References

MIPI CSI-2 Receiver 1.0 IP Core User Guide

Figure 1. DVI to VGA converter block diagram.

The IP is built from multiple blocks: lane merger, link-level protocol/video formatter, control logic and
optional debug modules.

5 Port Descriptions
6 Designing with the core

Copyright Digilent, Inc. All rights reserved.
